soundbio/ministat-1/Docs/Images/steps.png

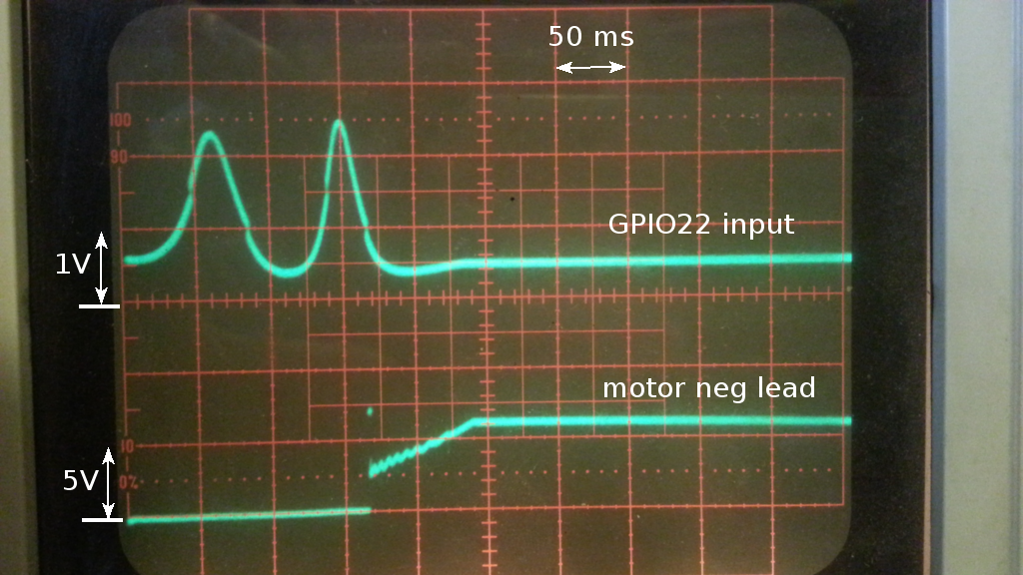
Docs/Images/steps.png
