soundbio/ministat-1/Docs/Images/tubing_thermistor.jpg

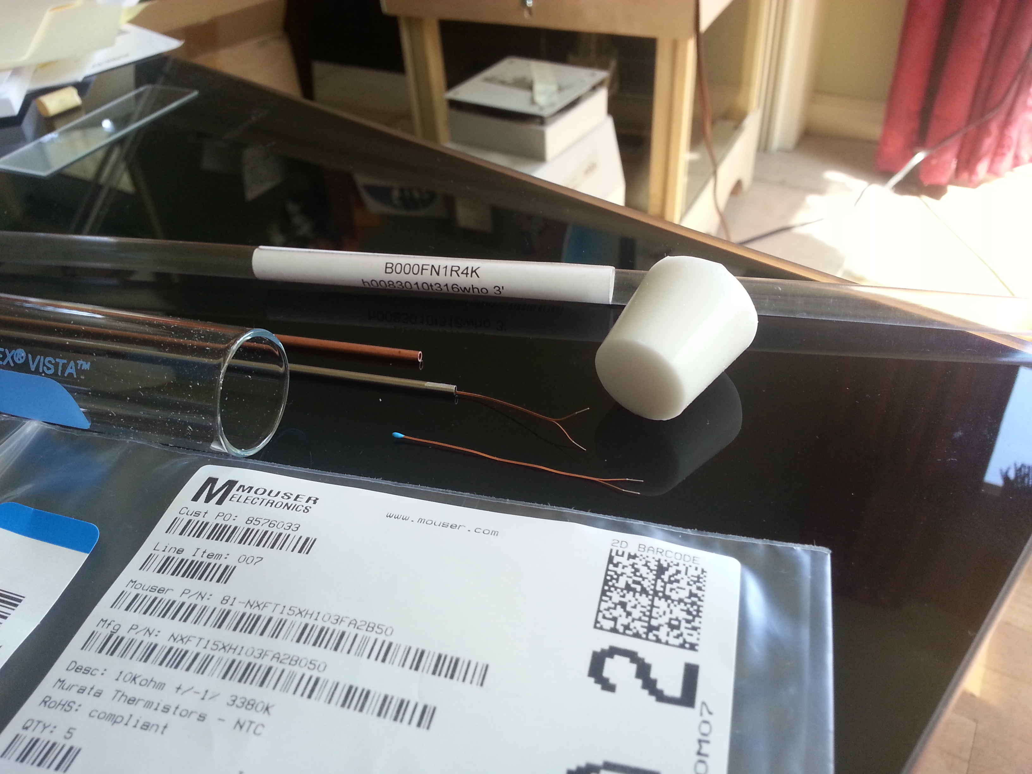
Docs/Images/tubing_thermistor.jpg
