soundbio/ministat-1/README.md

# ministat-1
An open source turbidostat for cell culture, being developed at HiveBio community biology lab in Seattle, WA http://hivebio.org/

## For more info, visit our wiki [here](https://github.com/hivebio/ministat-1/wiki)

Inspired by https://depts.washington.edu/soslab/turbidostat/pmwiki/pmwiki.php
