soundbio/ministat-1/Circuits/MiniStatPerfboard_bb.png

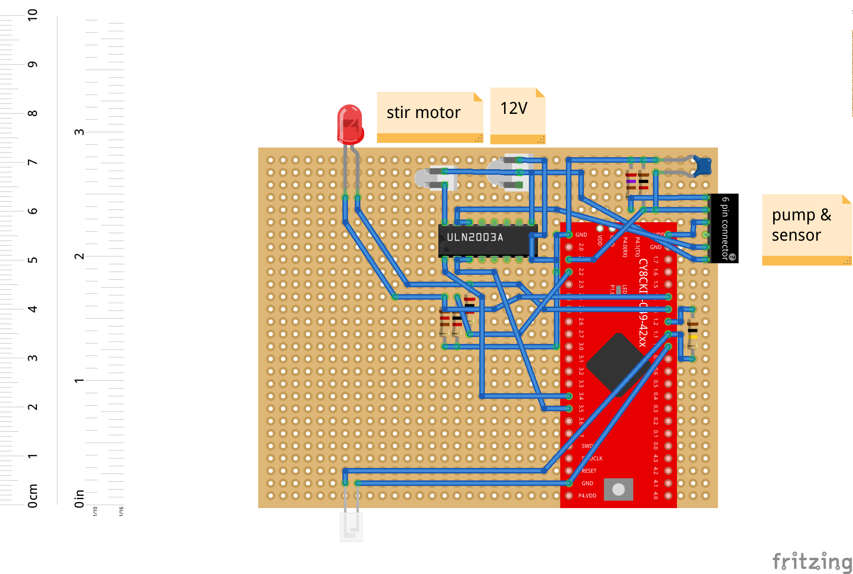
Circuits/MiniStatPerfboard_bb.png
