soundbio/ministat-1/Docs/Images/bridge_control_plot.png

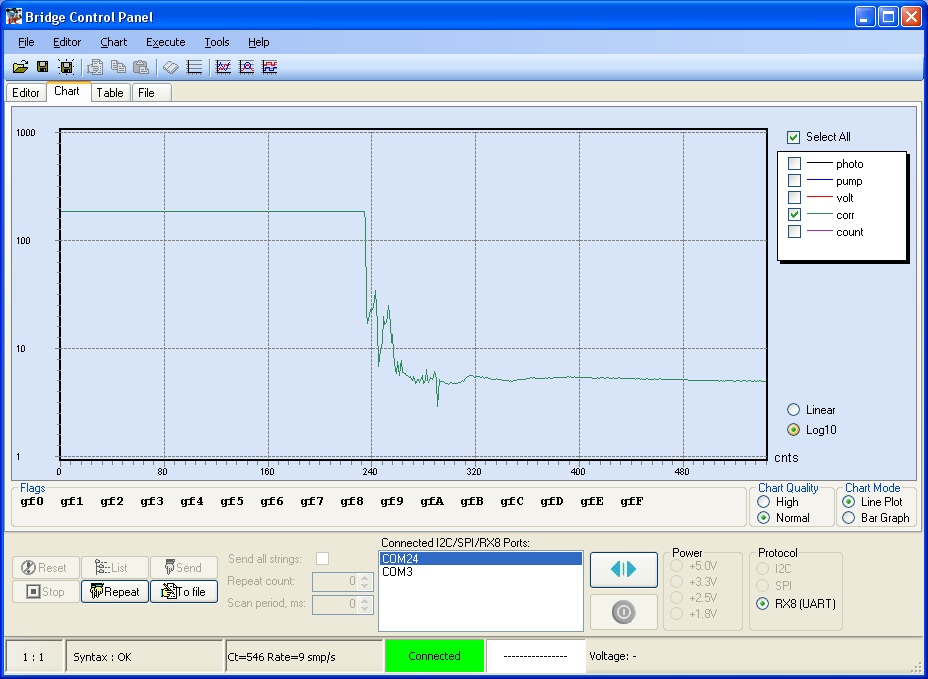
Docs/Images/bridge_control_plot.png
