soundbio/ministat-1/Docs/Images/bridge_control_vars.png

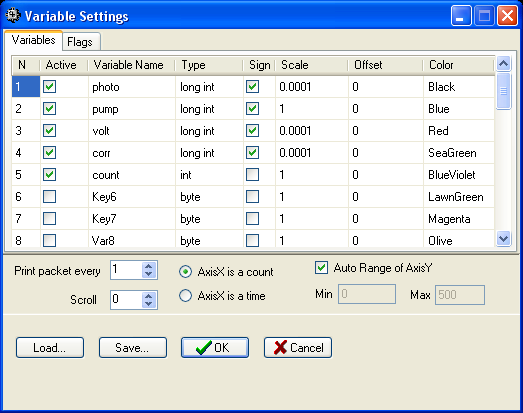
Docs/Images/bridge_control_vars.png
