soundbio/ministat-1/Docs/Images/heat_collar.jpg

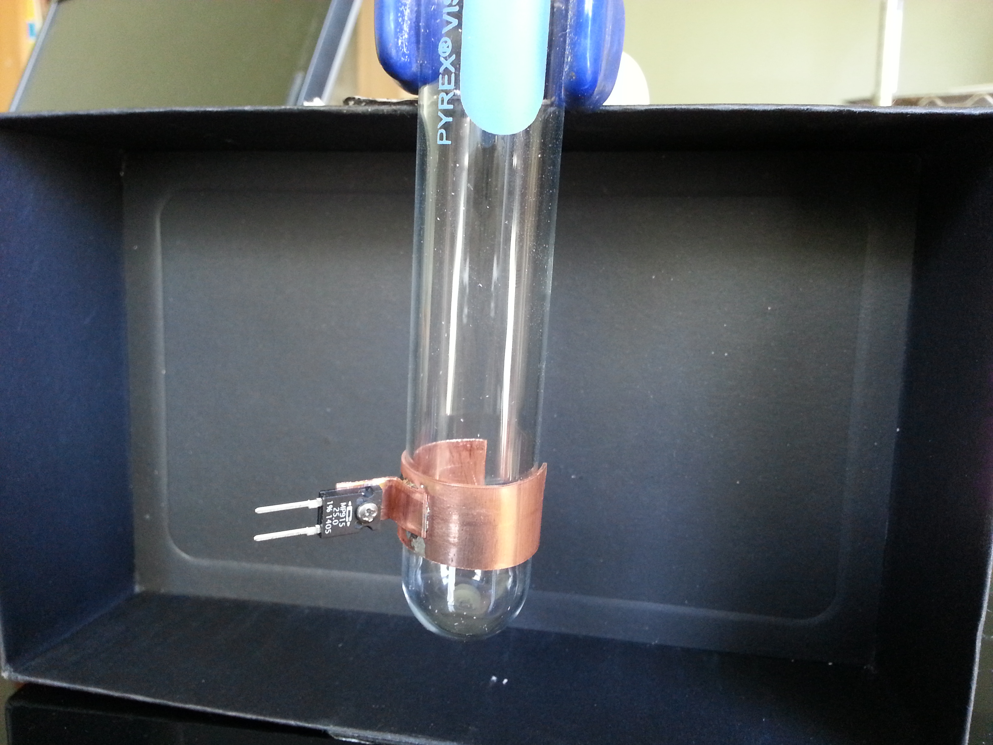
Docs/Images/heat_collar.jpg
