soundbio/ministat-1/Docs/Images/LEDs405-470.png

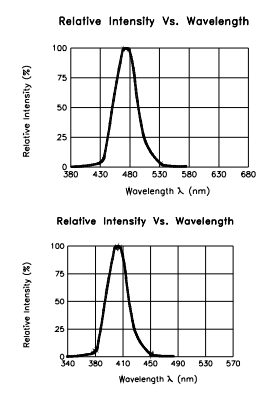
Docs/Images/LEDs405-470.png
