soundbio/ministat-1/Docs/Images/ministat1_p2_snap.png

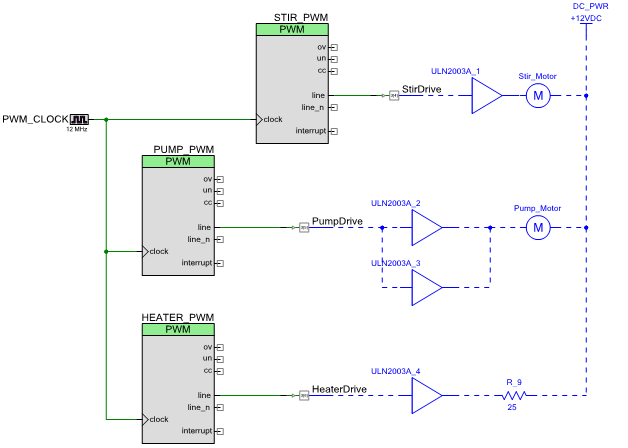
Docs/Images/ministat1_p2_snap.png
