soundbio/ministat-1/Docs/Images/ministat1_snap.png

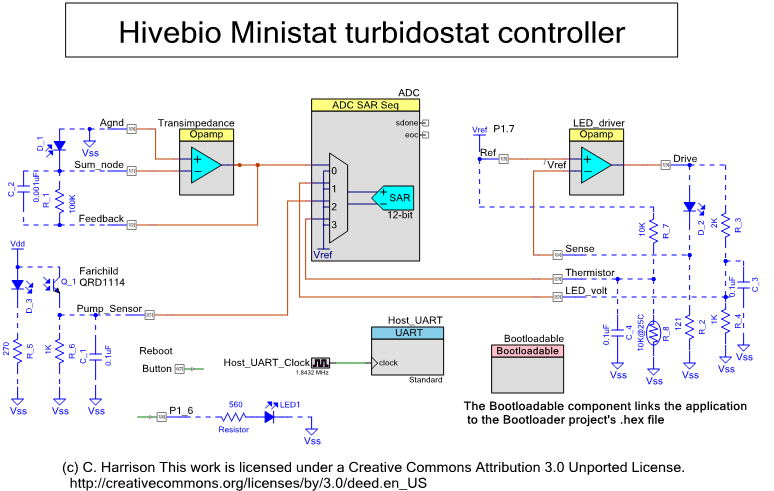
Docs/Images/ministat1_snap.png
