soundbio/ministat-1/Docs/Images/MinistatOverview.png

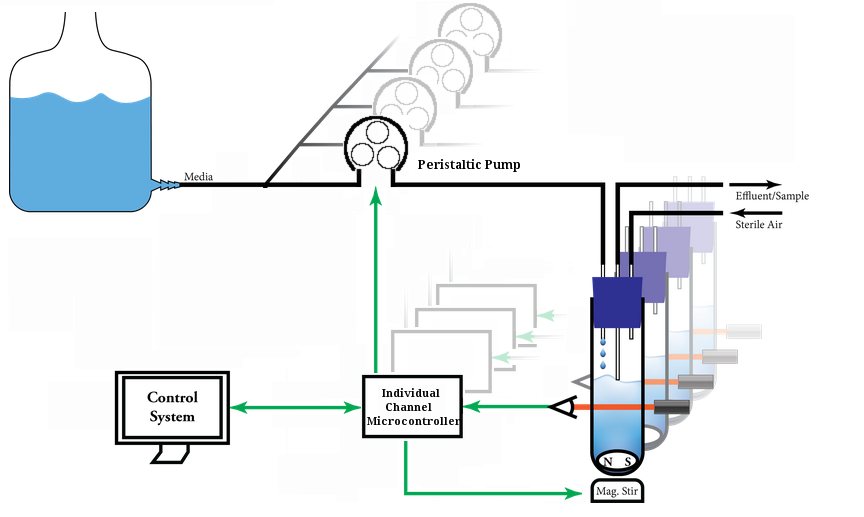
Docs/Images/MinistatOverview.png
