soundbio/ministat-1/Docs/Images/Optrode_Zhu_1992.jpg

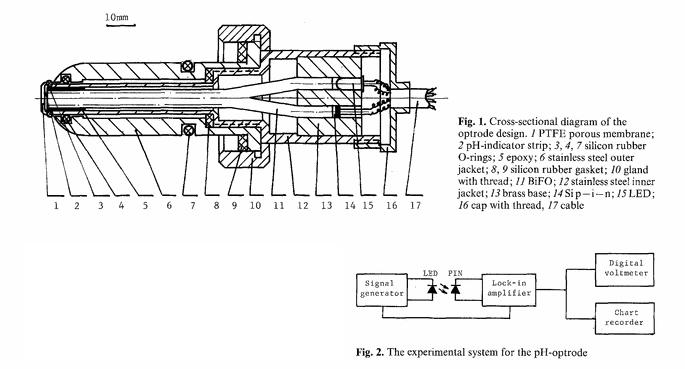
Docs/Images/Optrode_Zhu_1992.jpg
