soundbio/ministat-1/Docs/Images/peristaltic.jpg

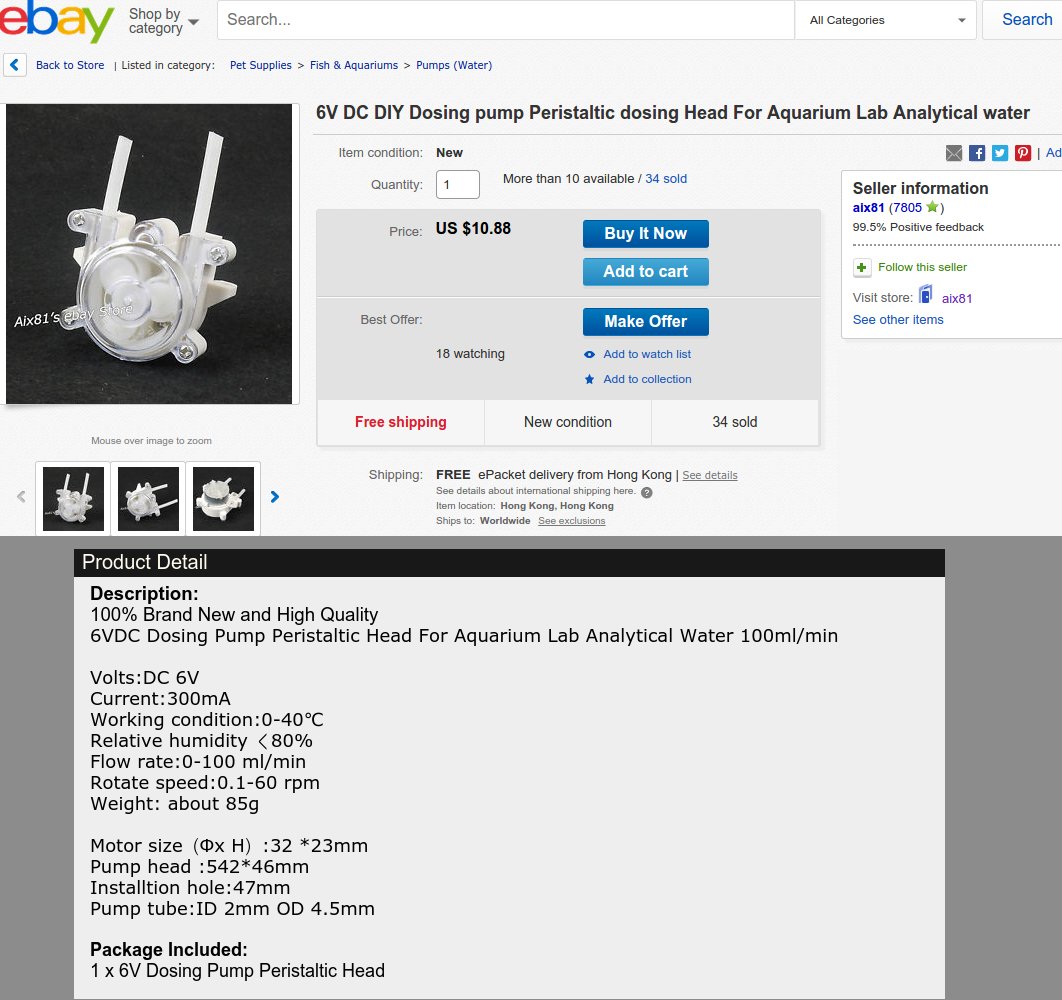
Docs/Images/peristaltic.jpg
