soundbio/ministat-1/Docs/Images/pHPyranine.png

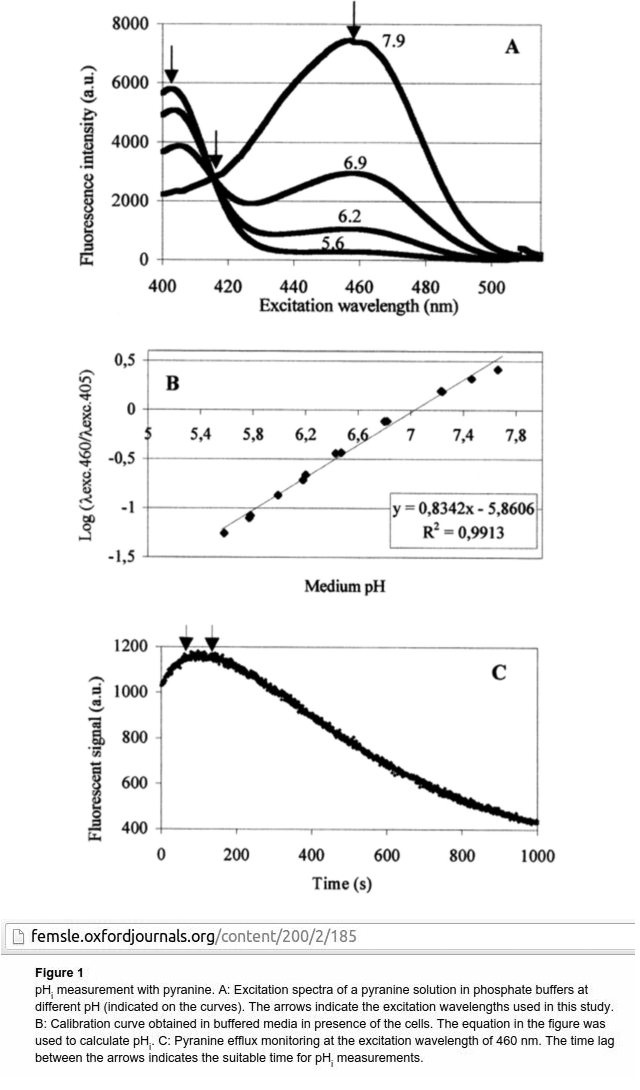
Docs/Images/pHPyranine.png
