soundbio/ministat-1/Docs/Images/pHstrips.jpg

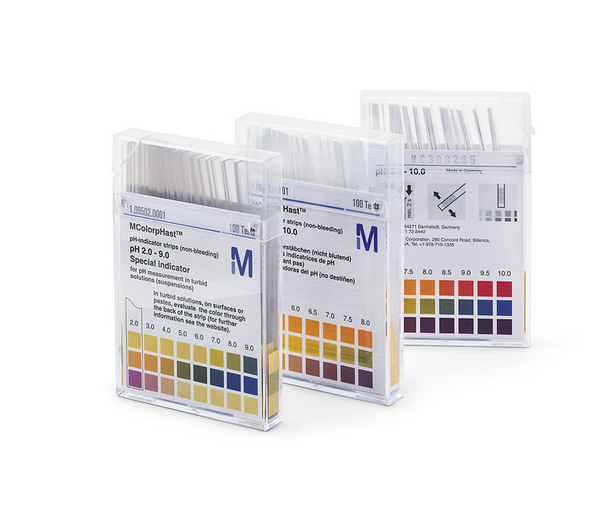
Docs/Images/pHstrips.jpg
