soundbio/ministat-1/Docs/Images/psoc_pinout.png

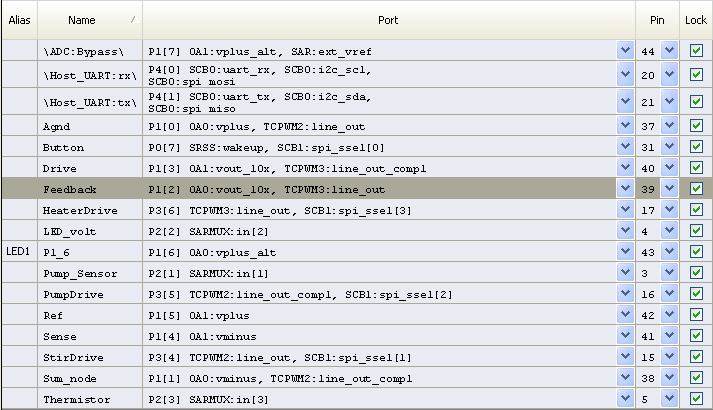
Docs/Images/psoc_pinout.png
