soundbio/ministat-1/Docs/Images/pump_sensor.jpg

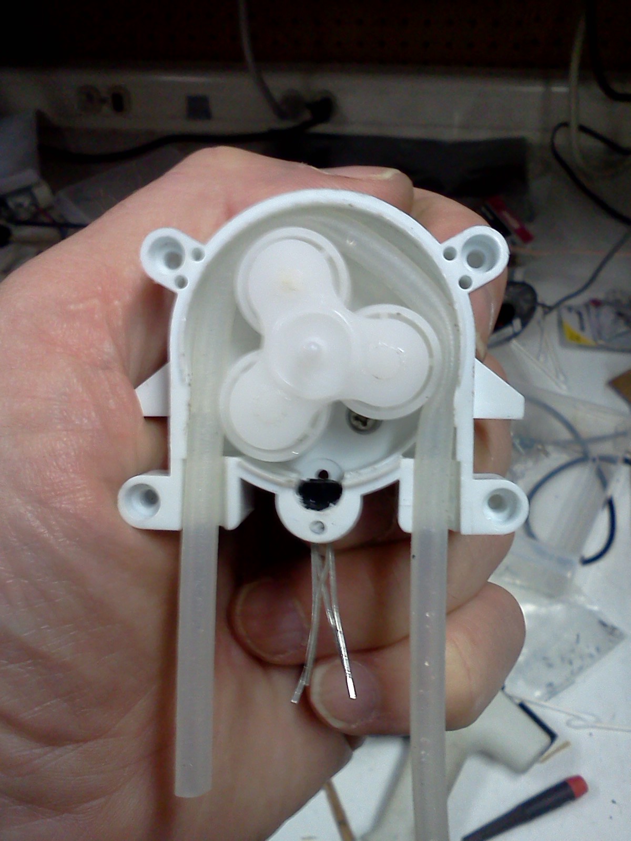
Docs/Images/pump_sensor.jpg
