soundbio/ministat-1/Docs/Images/pump_sensor_hole.jpg

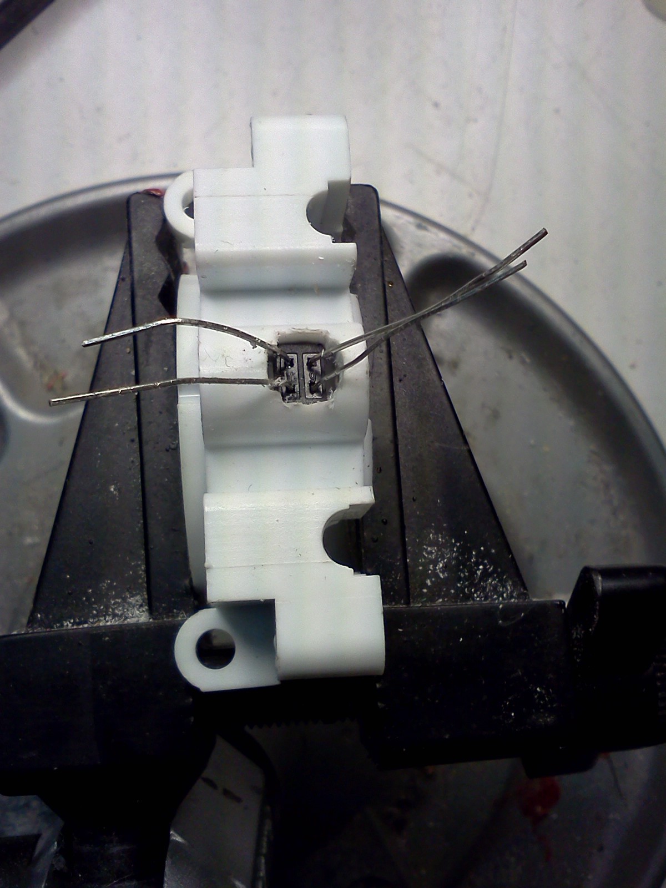
Docs/Images/pump_sensor_hole.jpg
