soundbio/ministat-1/Docs/Images/RPiPumpInterface-1.png

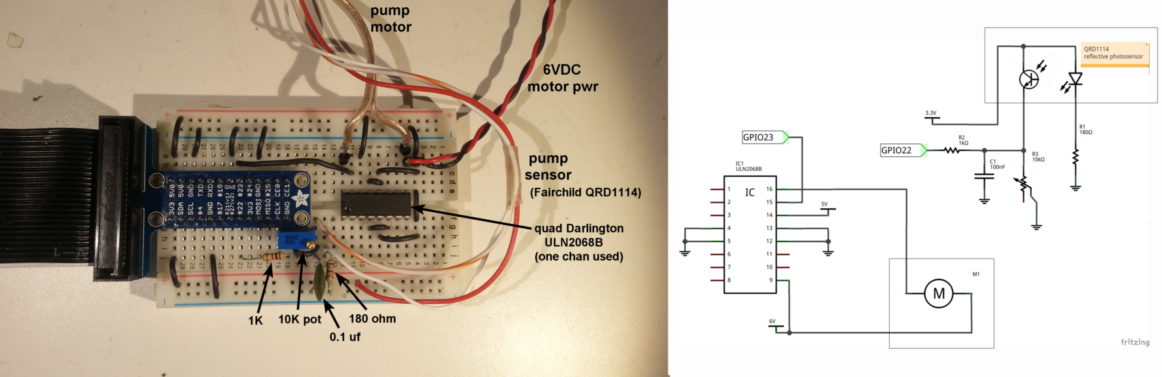
Docs/Images/RPiPumpInterface-1.png
