soundbio/ministat-1/Docs/Images/RTD_Kitchen_Cal.jpg

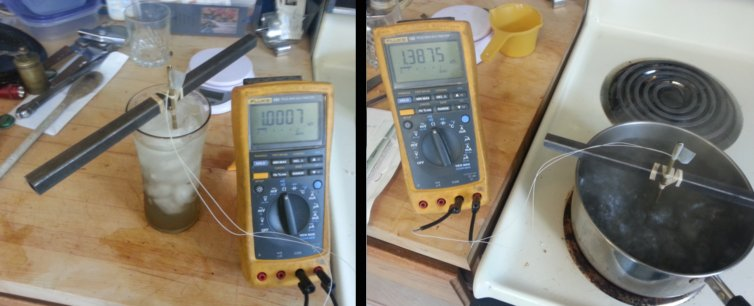
Docs/Images/RTD_Kitchen_Cal.jpg
