soundbio/ministat-1/Docs/Images/sensor_3Dprinted.jpg

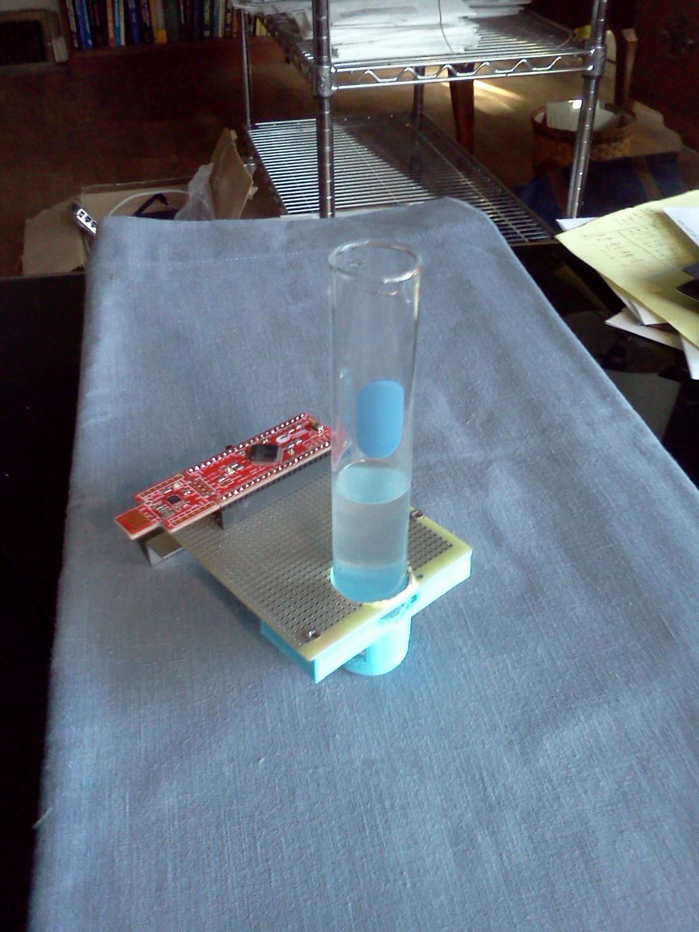
Docs/Images/sensor_3Dprinted.jpg
