soundbio/ministat-1/Docs/Images/sensor_drilledBlock.jpg

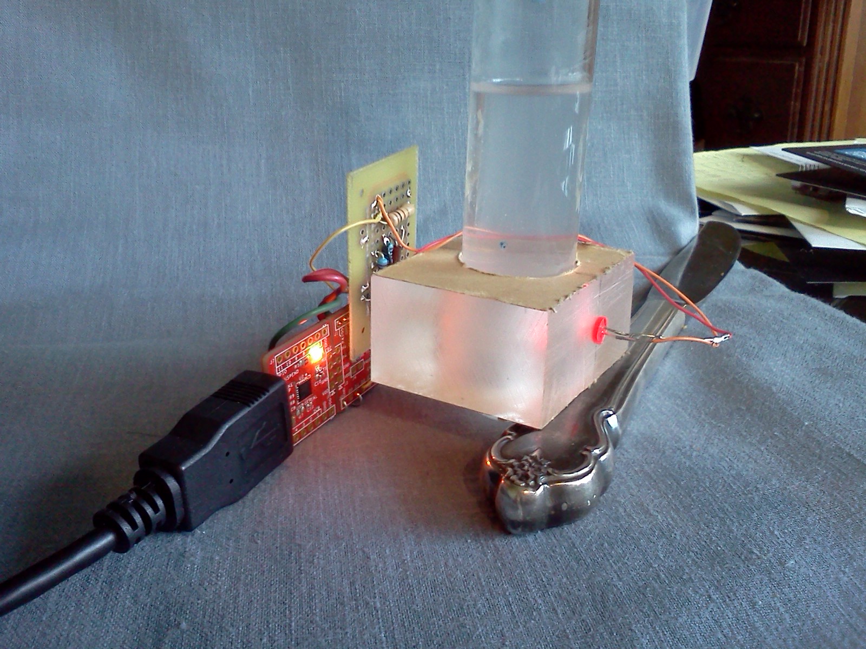
Docs/Images/sensor_drilledBlock.jpg
