soundbio/ministat-1/Docs/Images/spinner.jpg

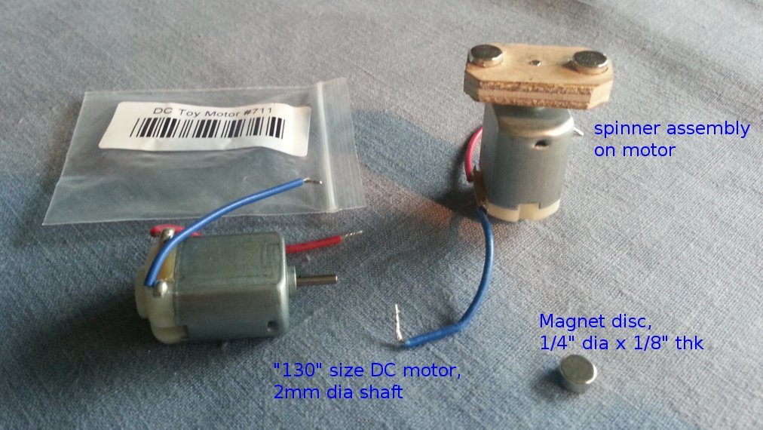
Docs/Images/spinner.jpg
