soundbio/ministat-1/Docs/Images/Thermistor_and_RTD.jpg

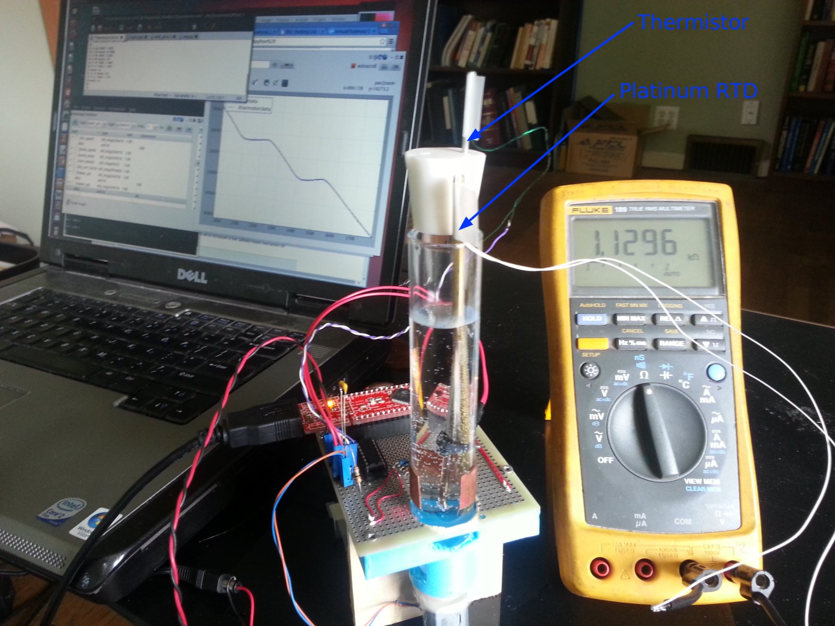
Docs/Images/Thermistor_and_RTD.jpg
