soundbio/ministat-1/Docs/Images/Thermistor_Cal_Points.png

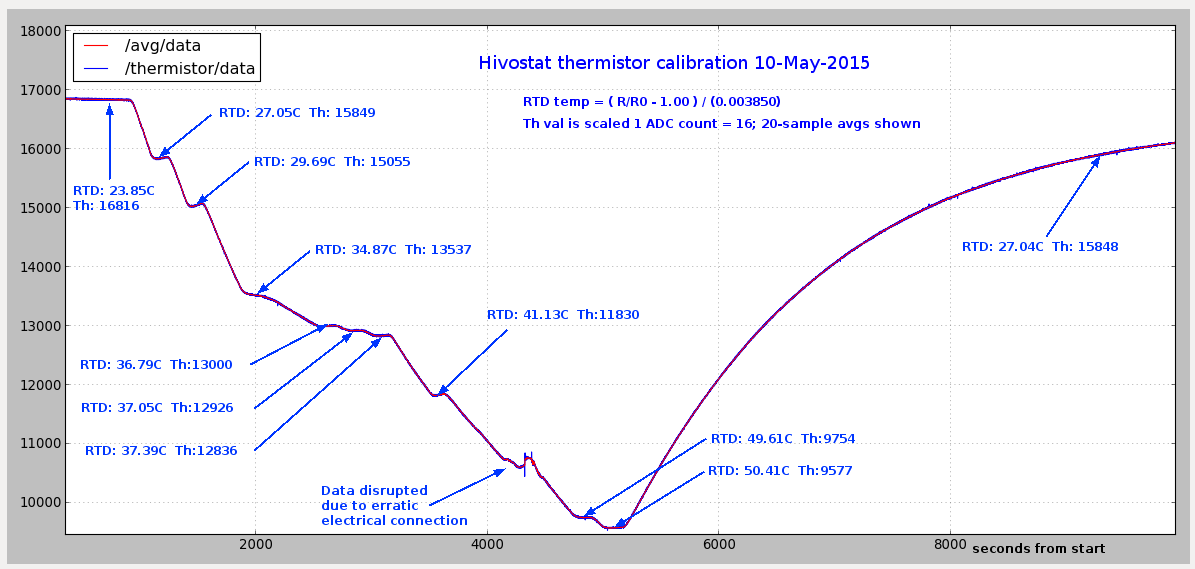
Docs/Images/Thermistor_Cal_Points.png
