soundbio/ministat-1/Docs/Images/Turbidistat.png

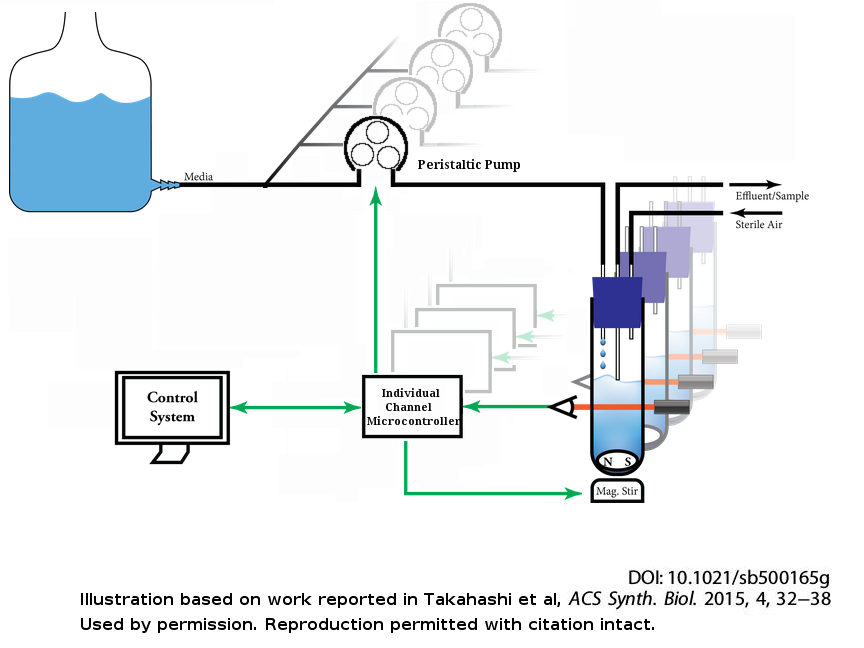
Docs/Images/Turbidistat.png
