soundbio/ministat-1/Docs/Images/two-led-signal.jpg

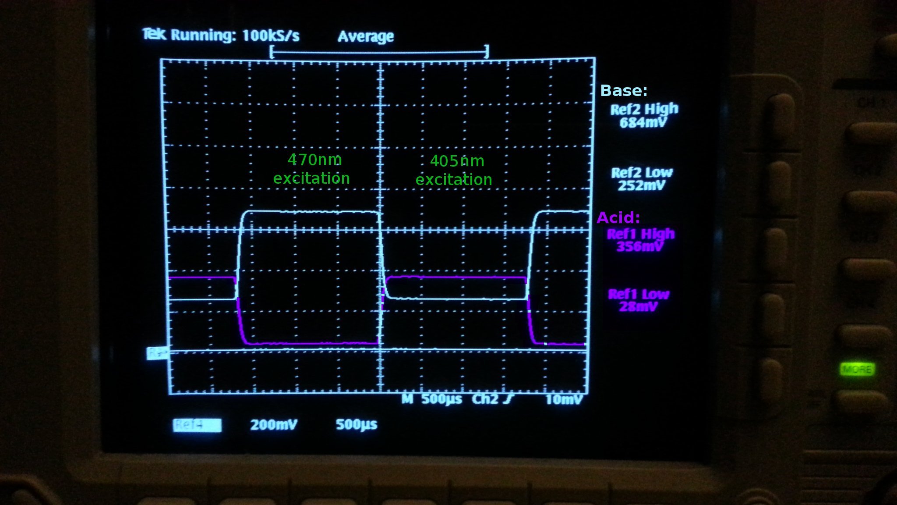
Docs/Images/two-led-signal.jpg
