soundbio/ministat-1/3D/chamber-v1.0.stl

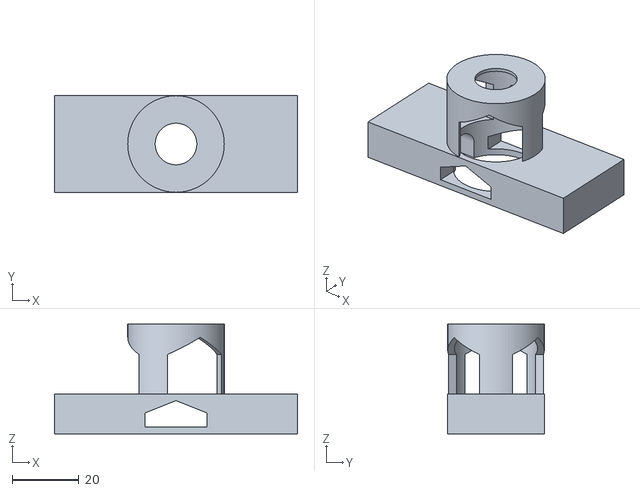
[picture p27: CAD file, 2015-02-23]
3D/chamber-v1.0.stl
73.0 x 29.0 x 33.0
