soundbio/ministat-1/(threads)

Thread 1 (2015-01-26):

Stir motor type: stepper or brushed?

chuck-h, 2015-01-26:
The UW turbidostat uses a stepper motor to turn the magnet hub for stirring. Apparently they recently switched motors and changed the circuit slightly because of supply problems with the first motor.

I suggest we use a small brushed motor like http://www.adafruit.com/products/711 .
* cheaper motor
* simpler drive (one transistor & diode)
* fewer microprocessor pins

Question: do we need speed control on the stirrer, or can we just give it a voltage and let it spin? This motor probably likes to run pretty fast, is that a problem?

ptschnack, 2015-01-26:
I was thinking about this too. I Googled: 'adafruit speed control dc motor' and got this:
https://learn.adafruit.com/adafruit-motor-selection-guide/dc-motor-control
Upshot: we can use cheap dc motor and drive it with pwm. (Whew! Expensive steppers are overkill for this.)

      From: chuck-h <notifications@github.com>
 To: hivebio/ministat-1 <ministat-1@noreply.github.com>
 Sent: Monday, January 26, 2015 8:35 AM
 Subject: [ministat-1] Stir motor type: stepper or brushed? (#1)

The UW turbidostat uses a stepper motor to turn the magnet hub for stirring. Apparently they recently switched motors and changed the circuit slightly because of supply problems with the first motor.I suggest we use a small brushed motor like http://www.adafruit.com/products/711 .
   - cheaper motor
   - simpler drive (one transistor & diode)
   - fewer microprocessor pins
Question: do we need speed control on the stirrer, or can we just give it a voltage and let it spin? This motor probably likes to run pretty fast, is that a problem?—
Reply to this email directly or view it on GitHub.

ptschnack, 2015-02-03:
The uController has PWM outputs, right? Can these be used to drive a transistor or other power amp to run the motor?

chuck-h, 2015-02-03:
PWM to a power transistor sounds like a great idea; I think we want about 1V at the motor.

zanghell, 2015-02-04:
is that to replace a motor controller ? sorry if I missed something in the thread.
Alex.

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

ptschnack, 2015-02-04:
Yes. Small DC motor controllers are often just a pulse width modulator driving a power output stage. The uControllers we are using can be used as PWM drivers, so the uController itself can drive the motor. We just need to add a very simple power/buffer stage. Probably just a transistor with protective diode and caps for filtering.
      From: Alexandre Zanghellini <notifications@github.com>
 To: hivebio/ministat-1 <ministat-1@noreply.github.com>
Cc: ptschnack <ptschnack@yahoo.com>
 Sent: Wednesday, February 4, 2015 10:05 AM
 Subject: Re: [ministat-1] Stir motor type: stepper or brushed? (#1)

is that to replace a motor controller ? sorry if I missed something in the thread.
Alex.

On Feb 3, 2015, at 12:44 AM, chuck-h <notifications@github.com> wrote:

> PWM to a power transistor sounds like a great idea; I think we want about 1V at the motor.

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

—
Reply to this email directly or view it on GitHub.

chuck-h, 2015-02-20:
Last week I received the small stir bars and ran one in water with the DC stir motor. I used a PWM microcontroller output driving one channel of a ULN2003A darlington array. Motor speed and distance from magnets to testube have to be controlled in order to get stable motion, but I think it will work.

Thread 2 (2015-02-09):

Experiment control computer: Raspberry Pi?

chuck-h, 2015-02-09:
Our system overview diagram shows a Control Computer managing multiple turbidostats.

In Klavins lab I think this was a PC running a python script.

I am leaning towards the idea of using a Raspberry Pi http://www.raspberrypi.org/  . In fact, I have ordered one of the newest model (Raspberry Pi 2) which looks to be plenty powerful enough to run an experiment, log the data, and communicate over Ethernet or Wifi to the surrounding world.

What do you think?

Chuck

zanghell, 2015-02-09:
Chuck,

I think it's the way to go. Actually, I don't know if you remembered but Will @ UW also used a Raspberry Pi to drive all the microcontrollers. It was the previous version.
I am happy to buy one if needed as well. I have been wanting to experiment with a Raspberry Pi for a while, and I am excited that we can start coding and interfacing the ministat with it.
Alex.

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

chuck-h, 2015-02-20:
Received my Pi2 and loaded Ubuntu 14.10 as described here:
http://www.raspberrypi.org/forums/viewtopic.php?f=56&t=98997&sid=c9d9428d6a9bf0077ab6f508357733ac

I was able to install precompiled ROS-base Indigo binaries as described here: http://wiki.ros.org/indigo/Installation/UbuntuARM , and added the http://wiki.ros.org/rosserial and http://wiki.ros.org/rosbridge_suite packages successfully. I also added rqt, a graphical monitoring/control interface gui for ROS, but it is not functioning properly for me yet.

I have been dallying on and off with the embedded side of ROS, e.g. http://wiki.jigren.org/index.php?title=RosOnAStick . I have been forked from the official rosserial tree at https://github.com/ros-drivers/rosserial for a while, but I am currently merging in the current indigo-devel branch and may have some worthwhile pull requests to offer back.

My vision is to move the RosOnAStick codebase into the "Hivostat" project here, and use a Pi2 to control any number of PSoC-based individual culture tubes.
