soundbio/ministat-1/(list of files, drawings)

Other design files:
Circuits/MiniStatPerfboard.fzz
