soundbio/ministat-1/HivoStatRos_PSoc5.cydsn/include/ros_lib/HardwareSerial.h

/*
  Copyright (c) 2011 Arduino.  All right reserved.

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
  You should have received a copy of the GNU Lesser General Public
  License along with this library; if not, write to the Free Software
  Foundation, Inc., 51 Franklin St, Fifth Floor, Boston, MA  02110-1301  USA
*/

#ifndef HardwareSerial_h
#define HardwareSerial_h

#include <inttypes.h>
#include <cstddef>

/* functions exposed by embedded_linux_comms
extern "C" int elCommInit(char *portName, int baud);
extern "C" int elCommRead(int fd);
extern "C" elCommWrite(int fd, uint8_t* data, int length);
*/

class HardwareSerial
{
  public:
    virtual void begin(unsigned long) = 0;
    virtual int read(void) = 0;
    virtual size_t write(uint8_t) = 0;
    virtual size_t write(uint8_t* data, int length) = 0;
} ;

#endif
