soundbio/ministat-1/HivoStatRos_PSoc5.cydsn/include/ros_lib/isnprintf.h

/******************************************************************************
*This file is for isnprintf()
*******************************************************************************/
#ifndef ISNPRINTF_H
#define ISNPRINTF_H
#include <inttypes.h>
#include <cstddef>

int isnprintf(char *s, int buf_len, const char *pszFmt,...);

#endif
/* [] END OF FILE */
