soundbio/ministat-1/(commit log)

2015-01-25 LED thermal drift correction
    [main.c]
2015-01-25 simplify printing code
2015-01-25 Add pump rotation sensor (adc input); remove LED current sensing
2015-01-25 pump photos for wiki
2015-01-25 pics of early sensor blocks
2015-02-01 magnetic stirrer drive image
2015-02-07 add peristaltic pump source image
2015-02-08 Add Stir Motor, Pump Motor drive pins; Listen on serial port.
2015-02-08 Pump Drive is now PWM; add numerical command line processing <nnn><single-letter-command>; RX8 output control to protect host system from spew
2015-02-09 Command number of pump feedback steps; add pinout list image
2015-02-10 Add chamber-v1.scad -- 3D printer source
    [chamber-v1.scad, chamber-v1.stl]
2015-02-24 Revise system timer and uart implementations
2015-02-24 more SysTimer millis purge
2015-02-24 ROS publish photo level; subscribe to stir and pump motor control topics
2015-03-02 Fritzing layout for perf board ministat
    [MiniStatPerfboard.fzz]
2015-03-04 fix circuit ULN2003A was ULN2803A
    [MiniStatPerfboard.fzz]
2015-03-04 add circuit breadboard layout picture
2015-03-09 Add connector for thermostatic control
    [MiniStatPerfboard.fzz]
2015-03-16 add thermal control I/O pins, adc chan
2015-03-16 add topics for led temperature correction, thermistor reading
    [main.cpp]
2015-03-23 Transimpedance opamp: set to high power (lower offset); add external feedback cap.
2015-03-25 set ADC rate to 6kHz exact (60Hz rejection); add light/dark raw topics
2015-03-29 increase ADC range from 1.024V to 2.048V
2015-03-29 cast ADC results to unsigned
2015-03-29 Thermistor response spreadsheet, Murata NXFT
    [ThermistorResponseNXFT.xlsx]
2015-04-04 add picture of thermistor and tubing for thermowell
2015-04-04 heating collar picture
2015-05-06 add heater PWM block
2015-05-10 Thermistor cal from RTD 10-May-2015
2015-05-10 add heater, thermistor bypass to PSoC schematic
2015-05-11 Thermistor linearization
2015-05-14 update non-ROS design with thermistor
2015-05-17 Update PSoC schematic and pinout images
2015-11-28 Add version minor to scad files.
    [chamber-v1.0.scad, chamber-v1.0.stl]
2015-11-28 Add raspberry-pi-2 pump test code.
2015-12-07 expanded thermistor calibration spreadsheet
    [ThermistorResponseNXFT.xlsx]
2015-12-07 perfboard fritzing update
    [MiniStatPerfboard.fzz]
2015-12-08 pump QRD1114 sensor test with software hysteresis
2015-12-08 remove unused variable in sensor test
2015-12-08 Add RPi pump interface image
2015-12-08 Add pump drive scope photo
2016-01-18 Improve USB Uart write efficiency (was 1 char per packet)
